sonali810/Electrospinning-Syringe-Pump/README.md

# Electrospinning-Syringe-Pump
This project creates a simple electrospinning syringe pump that incorporates an Arduino and motor.
Screenshot 2024-05-27 at 6 33 53 PM
Screenshot 2024-05-27 at 6 33 36 PM
